astroeng/Weather_Station/(threads)

Thread 1 (2016-01-14):

UV & IR & White Silkscreen swapped.

astroeng, 2016-01-14:

astroeng, 2016-01-14:
This is fixed... done in a previous commit before I figured out the linking thing.

Closed 2016-01-14.

Thread 2 (2016-01-14):

Radin module antenna in non optimal configuration when shield is not on top of the stack.

astroeng, 2016-01-14:

astroeng, 2016-01-14:
This will basically take a relayout of the board... I'm thinking that moving the RF24 device to where the voltage regulators are might be the best option.

Thread 3 (2016-01-14):

Cannot populate the onboard 5Volt regulator and the keep the 5V regulator on the arduino.

astroeng, 2016-01-14:
A jumper should be added to the 5 Volt trace going to the Arduino stack header. There is a jumper in the design for the 3.3 Volt trace

astroeng, 2016-01-14:
Updated the schematic and layout to contain 5V jumper.

Closed 2016-01-14.

Thread 4 (2016-01-14):

Silkscreen text listing the sensors needs to be reformatted.

astroeng, 2016-01-14:
When the board was made the text was automatically resized to a larger size that covers too much area on the board.

astroeng, 2016-01-14:
Updated the silkscreen so that nothing is smaller than 0.03" previously I was using 0.025"

Closed 2016-01-14.

Thread 6 (2016-03-05):

So memory is limited on the Arduino Uno..

astroeng, 2016-03-05:
Things are getting a bit tight on the Uno and I still have 3 more sensors to integrate. I have the hooks in place for the light sensors but none of the code to actually communicate with the sensor. In some test code it was apparent that adding those sensors pushed the design over the edge. To remedy this I could redesign the code on the Arduino to use less space, or I could add another device to do the memory intensive parts.
The memory seems to be used mostly by the Ethernet library in DNS and DHCP. Switching to a IP address vice a hostname saves a TON of memory, I didn't record the specifics.. So I will have to switch through the repository and record memory usage at different points. It is important to note that I am analyzing static memory using the compiler and making some guesses based on instrumented code for the dynamic stuff. My rule of thumb has been to have the static stuff not use more that 50%.
On the subject of another device... I could transition the whole project to a Mega... or RasPi, or BeagleBone. More to come on this discussion.

astroeng, 2016-05-28:
Ended up finding an old Mac Book for free, I installed Ubuntu Linux on it version 12.04 LTS bit old but still works for my needs. This computer runs the DataManager program, and the Arduino just sends messages to this computer locally. Currently that connection is TCP and is taking longer than expected for the Arduino to send a message to the DataManager computer.
