astroeng/Weather_Station/WeatherStation_PCB/weatherstation.brd

## EAGLE design WeatherStation_PCB/weatherstation.brd (2016-01-14)

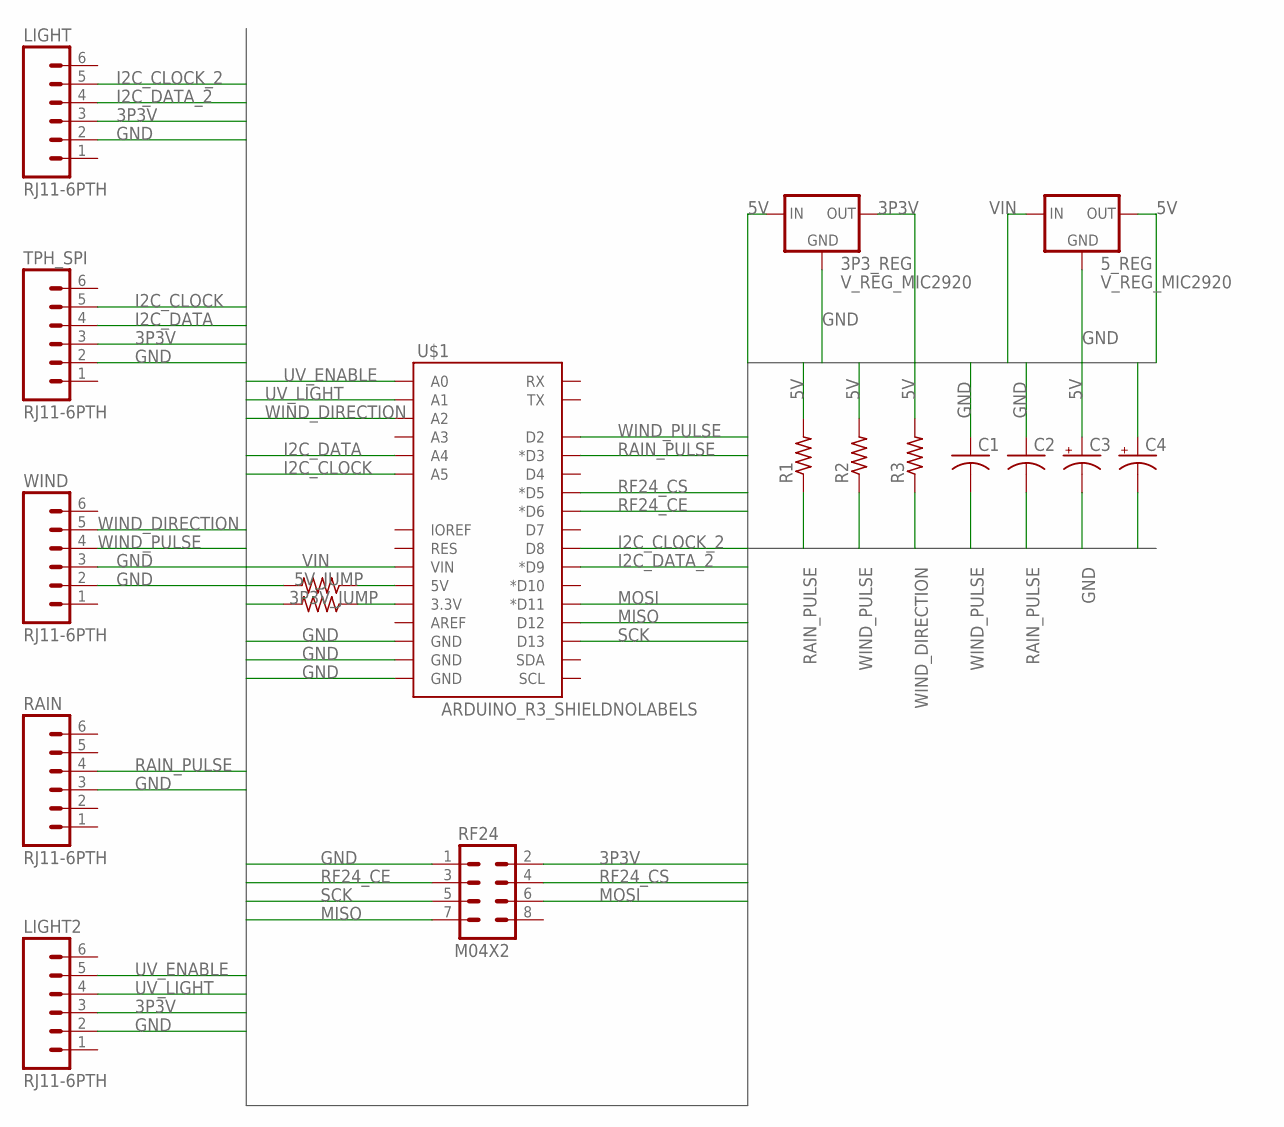
[picture p1: schematic weatherstation.sch]

Parts:
3P3V_JUMP, 5V_JUMP: R-US_R0805; R0805
3P3_REG, 5_REG: V_REG_MIC2920; SOT223
C1, C2: C-USC0805; C0805
C3, C4: CPOL-USE2.5-6; E2,5-6
LIGHT, LIGHT2: RJ11-6PTH; RJ11-6
R1, R2, R3: R-US_R0805; R0805
RAIN: RJ11-6PTH; RJ11-6
RF24: M04X2; 2X4
TPH_SPI: RJ11-6PTH; RJ11-6
U$1: ARDUINO_R3_SHIELDNOLABELS; UNO_R3_SHIELD_NOLABELS
WIND: RJ11-6PTH; RJ11-6

Connections:
3P3V: 3P3V_JUMP.2, 3P3_REG.3 (OUT), C4.+, LIGHT.3, LIGHT2.3, RF24.2, TPH_SPI.3
5V: 3P3_REG.1 (IN), 5V_JUMP.2, 5_REG.3 (OUT), C3.+, R1.2, R2.2, R3.2
GND: 3P3_REG.2 (GND), 5_REG.2 (GND), C1.1, C2.1, C3.-, C4.-, LIGHT.2, LIGHT2.2, RAIN.3, RF24.1, TPH_SPI.2, U$1.GND@0 (GND), U$1.GND@1 (GND), U$1.GND@2 (GND), WIND.2, WIND.3
I2C_CLOCK: TPH_SPI.5, U$1.A5
I2C_CLOCK_2: LIGHT.5, U$1.D8
I2C_DATA: TPH_SPI.4, U$1.A4
I2C_DATA_2: LIGHT.4, U$1.D9 (*D9)
MISO: RF24.7, U$1.D12
MOSI: RF24.6, U$1.D11 (*D11)
unnamed: 3P3V_JUMP.1, U$1.3.3V
unnamed: 5V_JUMP.1, U$1.5V
RAIN_PULSE: C2.2, R1.1, RAIN.4, U$1.D3 (*D3)
RF24_CE: RF24.3, U$1.D6 (*D6)
RF24_CS: RF24.4, U$1.D5 (*D5)
SCK: RF24.5, U$1.D13
UV_ENABLE: LIGHT2.5, U$1.A0
UV_LIGHT: LIGHT2.4, U$1.A1
VIN: 5_REG.1 (IN), U$1.VIN
WIND_DIRECTION: R3.1, U$1.A2, WIND.5
WIND_PULSE: C1.2, R2.1, U$1.D2, WIND.4

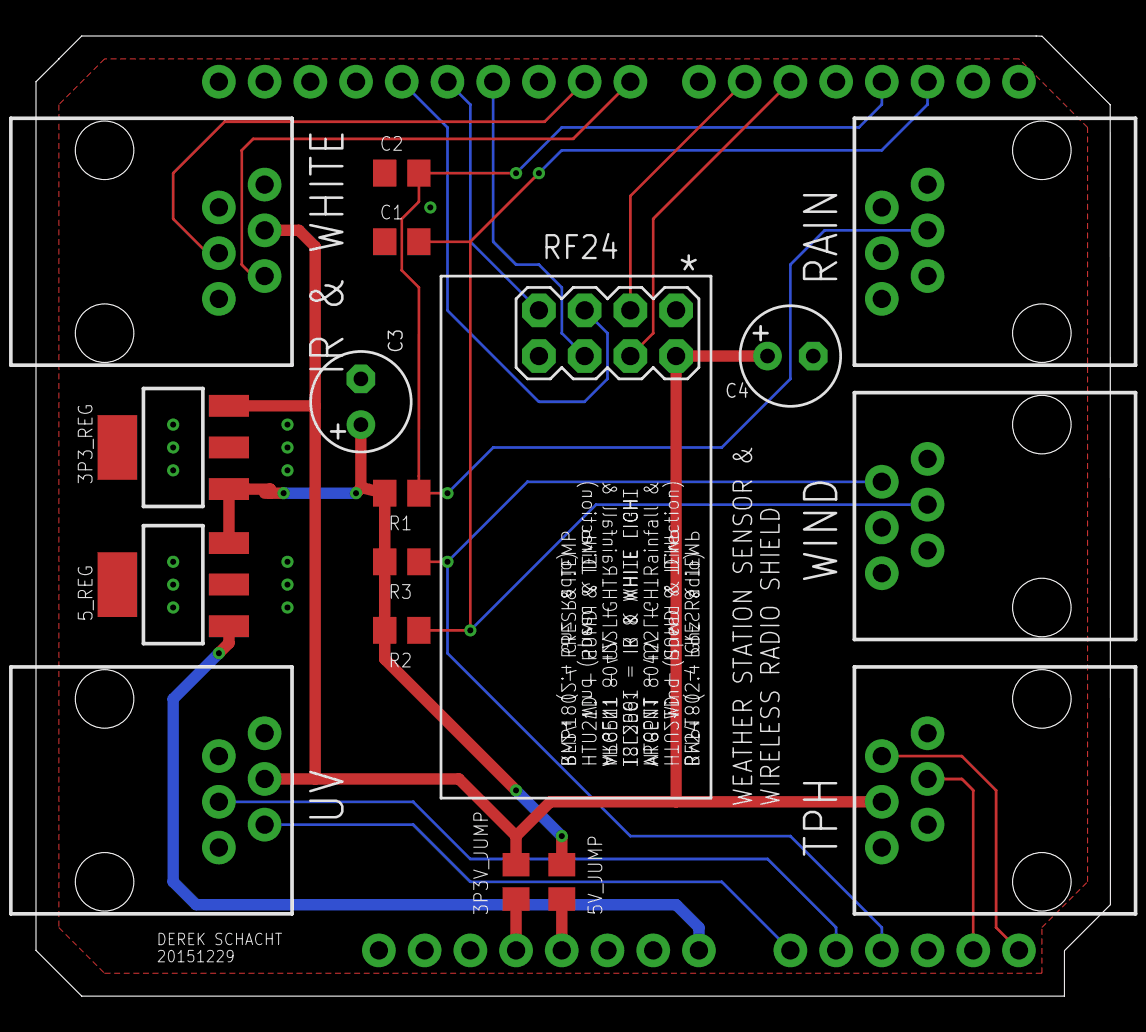
[picture p2: board weatherstation.brd from above]

Board: 2 copper layers, 59.7 x 53.3 mm, 18 parts (0 on the bottom side), 20 nets.
