astroeng/Weather_Station/Arduino_Code/WeatherStation/station_types.h

/* Derek Schacht
 *  2016 03 05
 *  License : Give me credit where it is due.
 *  Disclaimer : I try and site code that I find on the internet but I am not perfect. If you find
 *               something that should be sited let me know and I will update my code.
 *  Warranty   : Absolutely None
 *
 *  This header also applies to all previous commits. But, I reserve the right to modify this in the future.
 */

#ifndef STATION_TYPES_H
#define STATION_TYPES_H

#include "system_types.h"

typedef enum : u_int32
{
  WeatherMessage = 0x66647361,//('f' << 24) + ('d' << 16) + ('s' << 8) + 'a',
  StatusMessage  = 0x72657771,//('r' << 24) + ('e' << 16) + ('w' << 8) + 'q',
  QuitMessage    = 0x74697571,//('t' << 24) + ('i' << 16) + ('u' << 8) + 'q',
  InvalidMessage = 0x4FFFFFFF
} MessageKindType;


typedef struct
{
  u_int32 messageKind;
} StationHeaderType;

typedef struct
{
  u_int32 messageCount;
  u_int32 intervalTime;
  u_int32 humidity;
  u_int32 pressure;
  int32 temperature;
  u_int32 windDirection;
  u_int32 windSpeed;
  u_int32 windDirectionAtMaxWindSpeed;
  u_int32 maxWindSpeed;
  u_int32 windSpeedStdev;
  u_int32 irLight;
  u_int32 uvLight;
  u_int32 whiteLight;
} WeatherDataType;

typedef struct
{
  StationHeaderType header;
  WeatherDataType   data;
} WeatherMessageType;


typedef struct
{
  u_int32 messageCount;
  u_int32 task1_average_execution_time;
  u_int32 task1_max_execution_time;
  u_int32 task2_average_execution_time;
  u_int32 task2_max_execution_time;
  u_int32 task3_average_execution_time;
  u_int32 task3_max_execution_time;
  u_int32 task4_average_execution_time;
  u_int32 task4_max_execution_time;
  u_int32 batteryVoltage;
  u_int32 uptime;
} StatusDataType;

typedef struct
{
  StationHeaderType header;
  StatusDataType    data;
} StatusMessageType;

#endif
