astroeng/Weather_Station/(commit log)

2015-07-16 Initial commit for the weather station. This includes temperature, pressure, and humidity measurements. There are 3 working sensors so far MPL115A1, HTU21D, and BMP180.
2015-07-22 Updated to include changes made to the device libraries that brought them closer to the Arduino API patterns. Also update the output prints to match the units for local weather stations. This allows 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
2015-09-07 When debugging the initial String based implementation of this I noted some erratic behavior. In doing a bit of static analysis, I suspected that the chip was running out of RAM when trying to constr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
    [WeatherStation.ino, ethernet.cpp, ethernet.h]
2015-12-30 Bunch of changes... Ethernet got updated to use the TEST macro definition, and fixed a spelling mistake. The keys are now string definitions, this is to allow the preprocessor to work correctly... Sp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
    [WeatherStation.ino, ethernet.cpp, ethernet.h]
2016-01-08 Added the numerical statistics library to the computation of weather station values. Updated the data log call to use the new values. Updated the file with a ton of comments and discussion about the 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
    [WeatherStation.ino]
2016-01-11 Added a second logging function. The new logging function saves weather station system data. How long tasks are taking to run, battery voltage, and uptime. Also added message count to the existing me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
2016-01-11 Added a second logging task. The new logging task runs every 10 minutes and saves system data. Added support for reading a battery voltage. Added support for the numerical side of the light sensors. 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
2016-01-12 Added rainfall processing. Also updated the digital sensor function to run every 166ms. Cleaned up and added comments. Restructured the setup routine so that the WDT will catch and reset initializati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
    [WeatherStation.ino]
2016-01-13 Based on a suggestion from a friend I restructured the logging utilities. The same friend suggested restucturing the use of the Numerical Statistics class. Both of these changes were done to reduce t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
2016-01-13 Used the wrong end value on the for loop in the system log function, updated to use the correct one. In response to the last commit.. something interesting of note: The last commit was compiled on Ar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
2016-01-13 Updated the logging functionality again.. I thought I introduced a bug that caused the Arduino to reset every so often with the last update, and that still might be the case. However, in doing some r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
    [WeatherStation.ino, ethernet.cpp]
2016-01-13 Deleted function prototypes from header file. These should have been deleted with the last commit.
2016-01-14 Moved the code into a subdirectory and then added the PCB layout files to the project.
    [weatherstation.GBL, weatherstation.GBO, weatherstation.GBS, weatherstation.GKO, weatherstation.GTL, weatherstation.GTO, weatherstation.GTS, weatherstation.XLN]
2016-01-14 Moved the code into a subdirectory and then added the PCB layout files to the project. These are the files that were used to produce the first run board.
    [weatherstation.GBL, weatherstation.GBO, weatherstation.GBS, weatherstation.GKO, weatherstation.GTL, weatherstation.GTO, weatherstation.GTS, weatherstation.XLN]
2016-01-14 Fixed Issue #3 Updated the design to contain the 5V jumper.
    [weatherstation.brd, weatherstation.sch]
2016-01-14 Updated to fix issue #4. The silkscreen now uses 0.03 as the smallest text. Additionally, removed the eagle cache files.
    [weatherstation.brd]
2016-01-22 Complete reorganization, I Wanted to reduce the size of the main file. Each task has been broken into separate files, physical configuration items have been collected into one file, and a global data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
    [WeatherStation.ino, config.h, digital_task.cpp, digital_task.h, discrete_task.cpp, discrete_task.h, ethernet.cpp, ethernet.h]
2016-02-02 Added the current state of the PIC code for the weather station. So far the old MPL115a1 sensor and the TSL2561 luminosity sensor are supported.
2016-02-02 Fixed a folder nesting issue caused when the PIC code was added.
    [config.h, digital_task.cpp, digital_task.h, discrete_task.cpp, discrete_task.h, global_data.cpp, global_data.h, system_log_task.cpp]
2016-02-05 The System Timer is the only ISR that should be using the shadow registers. The other ISRs have been updated to not use the shadow registers. Added support for the ADC module.
2016-02-12 Updated the adc support to remove the need for an ISR. I realized that for this application the interrupt was not doing anything useful. The ADC module is just setup to auto sample and then the code 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
2016-02-12 Updated the SPI module with a tested implementation of SPI slave operation. This has one fundamental flaw... at high spi clock rates (4mhzish and up) The ISR cannot keep up with the incomming data. T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
2016-02-12 This is the code that was used to test the PIC in SPI slave mode.
2016-02-28 Initial commit for the Data Manager Application that will run on my home router. The intention is to offload the string building from the Arduino. Hopefully this will remove the 1+ second string buil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
2016-02-29 Executed this simple program on the E2500 router running DDWRT 29114-mega compiled with the toolchain-mipsel_4.1.1_BRCM24 toolchain. The program was able to print text sent to the router via a raw co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
    [main.cpp, phant_interface.h, phant_strings.h, station_interface.cpp, station_interface.h, system_types.h]
2016-02-29 Updated to forever wait for messages in a loop. Also tested the execution of the program on the WNDR4000 with DDWRT 18687. I used the same compiler as before so still need to figure the toolchain thi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
    [main.cpp, station_interface.cpp, station_interface.h]
2016-03-02 Changed TCP_Server to have an accept method that returns a TCP_Client, this change makes it a bit more obvious of what is going on for use. Also updated the main code to actually send messages to the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
2016-03-04 Moved the message processing function into the station interface file. Removed the phant interface files since those were OBE and leftover from the microcontroller code. Updated some of the construct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
    [main.cpp, station_interface.cpp, station_interface.h, system_error.cpp, system_error.h, system_utilities.cpp, system_utilities.h, tcp_client.cpp]
2016-03-04 Updated the header definitions to make it easier to see which messages are on Wireshark.
2016-03-05 Updated the Arduino side of the interface to use the new interface with the data manager.
2016-03-31 Renamed the local ethernet class to tcp_client, Updated the IPAddress definition to use the correct type.
    [WeatherStation.ino, global_data.cpp, global_data.h, station_types.h, tcp_client.cpp, tcp_client.h]
2016-04-03 Updated a couple of includes that were exploiting a case insensitive filesystem. Updated the Datamanager IP address to be a linux computer vice the router. This is being done since the software keeps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
    [WeatherStation.ino, digital_task.cpp, global_data.cpp, global_data.h]
2016-06-14 In the middle of swapping from gethostbyname to getaddrinfo. This is a working getaddrinfo implementation, however cleanup is needed.
    [station_interface.cpp, tcp_client.cpp, tcp_client.h]
2016-06-16 Switched the Ardiuno to DataManager interface over to UDP. This was done in an effort to reduce the communication task execution times. In that regard it succeeded however, a couple of bugs were intr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
    [WeatherStation.ino, client_interface.cpp, client_interface.h, digital_task.cpp, main.cpp, station_interface.cpp, station_interface.h, tcp_client.cpp]
2016-06-16 Found the bug that was causing the weather message after a status message to get corrupted. Also, added a function to system_utilities that will return a formatted date & time string. This will event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
    [main.cpp, system_utilities.cpp, system_utilities.h]
2016-10-04 Small cleanup and fixed the makefile for the the rasPi
    [client_interface.cpp, client_interface.h, tcp_client.cpp, tcp_server.cpp]
2016-10-07 Updated some formatting in several files. Added DEBUG defines to enable quickly turning debug code on and off. Removed the old TCP processing code since it is no longer used. Testing revealed a bug t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
    [client_interface.cpp, main.cpp, numerical_statistics.cpp, station_interface.cpp, tcp_client.cpp]
